adsehgal/STM_Dev_Boards/RedPill2/RedPill BOM.xlsx

LCSC Part Number | Manufacture Part Number | Manufacturer | Package | Customer # | Description | RoHS | Order Qty. | Min\Mult Order Qty. | Unit Price | Order Price | Product Link
C340475 | RMC1/10-104JTP | KAMAYA | 0805 |  | 100K ±5% 1/8W ±200ppm/℃ 0805 Chip Resistor - Surface Mount RoHS | yes | 50 | 50 | 0.003652 | 0.18 | lcsc.com/product-detail/Chip-Resistor-Surface-Mount_KAMAYA-RMC1-10-104JTP_C340475.html
C389817 | 7325-0800A2010-00 | XTY | SMD-3225-4P |  | 8MHz ±10ppm 20pF 400Ω SMD-3225-4P SMD Crystal Resonators RoHS | yes | 1 | 1 | 0.180555 | 0.18 | lcsc.com/product-detail/SMD-Crystal-Resonators_XTY-7325-0800A2010-00_C389817.html
C116501 | PTS810SJM250SMTRLFS | C&K | SMD |  | SPST-NO 50mA @ 16VDC Top Actuated Standard SMD Tactile Switches RoHS | yes | 1 | 1 | 0.178788 | 0.18 | lcsc.com/product-detail/Tactile-Switches_C-K-PTS810SJM250SMTRLFS_C116501.html
C48615 | Q13FC1350000200 | Seiko Epson | SMD-3215_2P |  | 32.768KHz ±20ppm 7pF 70kΩ SMD-3215_2P SMD Crystal Resonators RoHS | yes | 1 | 1 | 0.15303 | 0.15 | lcsc.com/product-detail/SMD-Crystal-Resonators_Seiko-Epson-Q13FC1350000200_C48615.html
C8734 | STM32F103C8T6 | STMicroelectronics | LQFP-48_7x7x05P |  | 32-Bit FLASH ARM® Cortex®-M3 72MHz 2V ~ 3.6V LQFP-48_7x7x05P ST Microelectronics RoHS | yes | 1 | 1 | 1.936364 | 1.94 | lcsc.com/product-detail/ST-Microelectronics_STMicroelectronics-STM32F103C8T6_C8734.html
C205449 | ORH-YG35A | Orient | 0805 |  | Green-yellow 566nm 0805 Light Emitting Diodes (LED) RoHS | yes | 50 | 50 | 0.008272 | 0.41 | lcsc.com/product-detail/Light-Emitting-Diodes-LED_Orient-ORH-YG35A_C205449.html
C163968 | WR08X1004FTL | Walsin Tech Corp | 0805 |  | 1M ±1% 1/8W ±100ppm/℃ 0805 Chip Resistor - Surface Mount RoHS | yes | 100 | 100 | 0.002043 | 0.2 | lcsc.com/product-detail/Chip-Resistor-Surface-Mount_Walsin-Tech-Corp-WR08X1004FTL_C163968.html
C408926 | CR-05JA7---20R | Viking Tech | 0805 |  | 20 ±5% 1/8W ±100ppm/℃ 0805 Chip Resistor - Surface Mount RoHS | yes | 100 | 100 | 0.001855 | 0.19 | lcsc.com/product-detail/Chip-Resistor-Surface-Mount_Viking-Tech-CR-05JA7-20R_C408926.html
C115337 | RS-05K512JT | FH(Guangdong Fenghua Advanced Tech) | 0805 |  | 5.1K ±5% 1/8W ±100ppm/℃ 0805 Chip Resistor - Surface Mount RoHS | yes | 100 | 100 | 0.002257 | 0.23 | lcsc.com/product-detail/Chip-Resistor-Surface-Mount_FH-Guangdong-Fenghua-Advanced-Tech-RS-05K512JT_C115337.html
C119075 | RS-05K331JT | FH(Guangdong Fenghua Advanced Tech) | 0805 |  | 330 ±5% 1/8W ±100ppm/℃ 0805 Chip Resistor - Surface Mount RoHS | yes | 100 | 100 | 0.002133 | 0.21 | lcsc.com/product-detail/Chip-Resistor-Surface-Mount_FH-Guangdong-Fenghua-Advanced-Tech-RS-05K331JT_C119075.html
C103904 | RTT051002FTP | RALEC | 0805 |  | 10K ±1% 1/8W ±100ppm/℃ 0805 Chip Resistor - Surface Mount RoHS | yes | 100 | 100 | 0.002046 | 0.2 | lcsc.com/product-detail/Chip-Resistor-Surface-Mount_RALEC-RTT051002FTP_C103904.html
C465168 | HGC0805G0220J500NTGJ | Chinocera | 0805 |  | 22pF ±5% 50V C0G 0805 Multilayer Ceramic Capacitors MLCC - SMD/SMT RoHS | yes | 50 | 50 | 0.010723 | 0.54 | lcsc.com/product-detail/Multilayer-Ceramic-Capacitors-MLCC-SMD-SMT_Chinocera-HGC0805G0220J500NTGJ_C465168.html
C116352 | CL21B105KAFNNNE | Samsung Electro-Mechanics | 0805 |  | 1uF ±10% 25V X7R 0805 Multilayer Ceramic Capacitors MLCC - SMD/SMT RoHS | yes | 50 | 50 | 0.012231 | 0.61 | lcsc.com/product-detail/Multilayer-Ceramic-Capacitors-MLCC-SMD-SMT_Samsung-Electro-Mechanics-CL21B105KAFNNNE_C116352.html
C282732 | TCC0805X7R104K500DT | CCTC | 0805 |  | 100nF ±10% 50V X7R 100nF ±10% 50V X7R 0805 Multilayer Ceramic Capacitors MLCC - SMD/SMT RoHS | yes | 50 | 50 | 0.01487 | 0.74 | lcsc.com/product-detail/Multilayer-Ceramic-Capacitors-MLCC-SMD-SMT_CCTC-TCC0805X7R104K500DT_C282732.html
C39051 | MCP1700T-3302E/TT | Microchip Tech | SOT-23(SOT-23-3) |  | Fixed 6V 3.3V 250mA SOT-23(SOT-23-3) Low Dropout Regulators(LDO) RoHS | yes | 1 | 1 | 0.280303 | 0.28 | lcsc.com/product-detail/Low-Dropout-Regulators-LDO_Microchip-Tech-MCP1700T-3302E-TT_C39051.html
