adsehgal/STM_Dev_Boards/RedPill2/Schematic.pdf

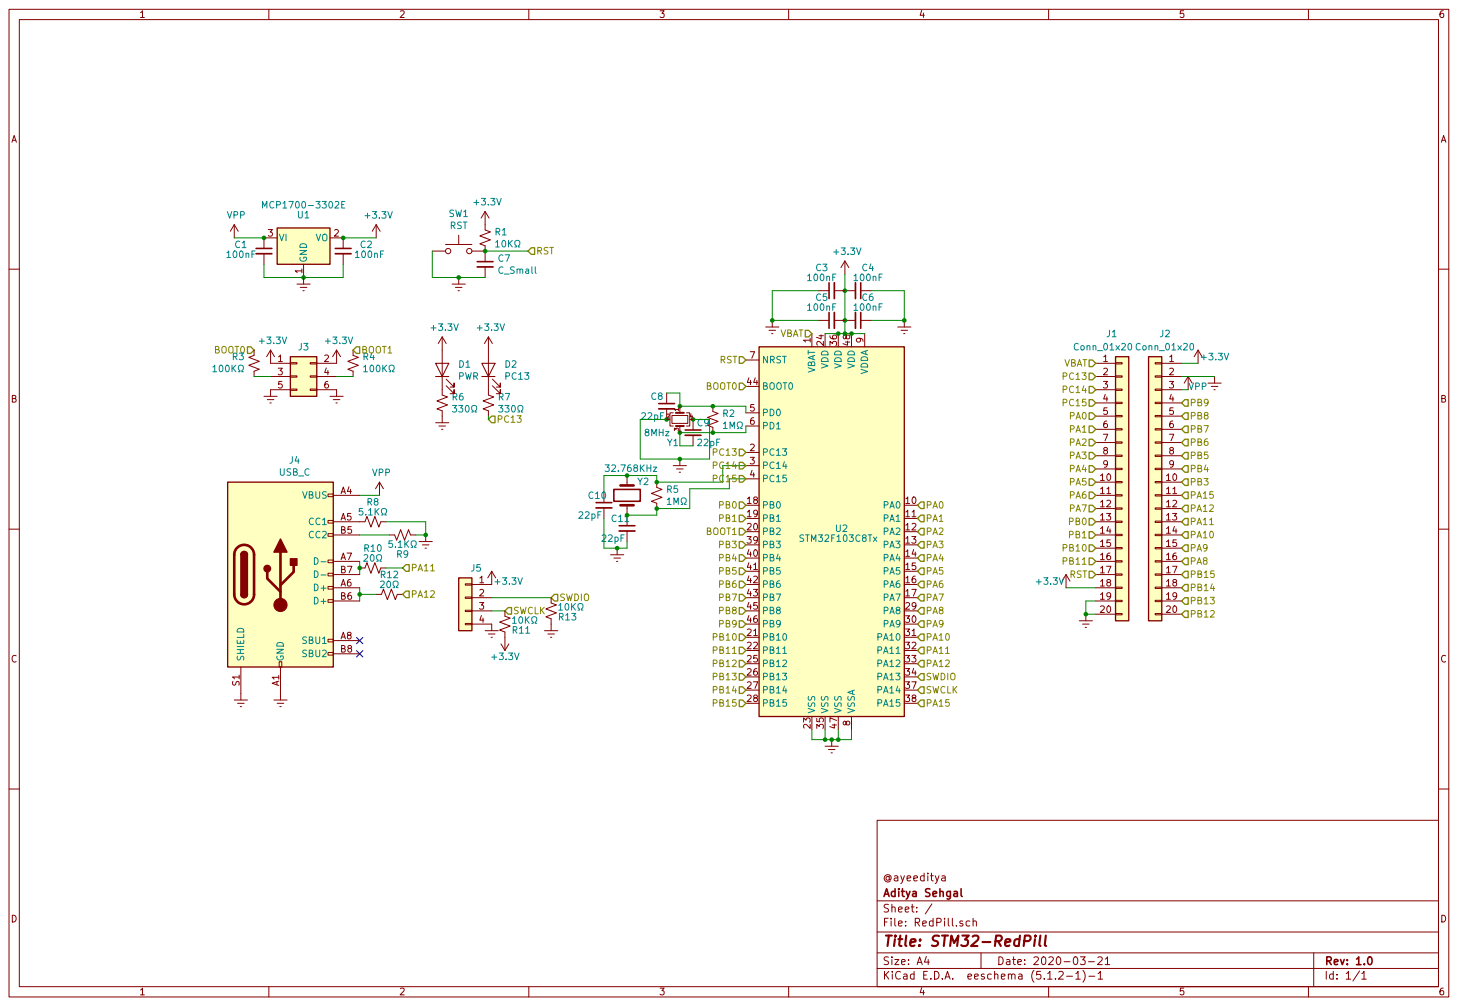
[picture p1: page 1]

1 VDD 24 VDD 36 VDD 48 VDDA

9 VSS 23 VSS 35 VSS 47 VSSA

@ayeeditya
Id: 1/1 Title: STM32-RedPill File: RedPill.sch Sheet: / Aditya Sehgal
