adsehgal/STM_Dev_Boards/STM32F103Cxxx/STM32F103Cxxx.kicad_sch

## KiCad design STM32F103Cxxx/STM32F103Cxxx.kicad_sch (2020-09-07)

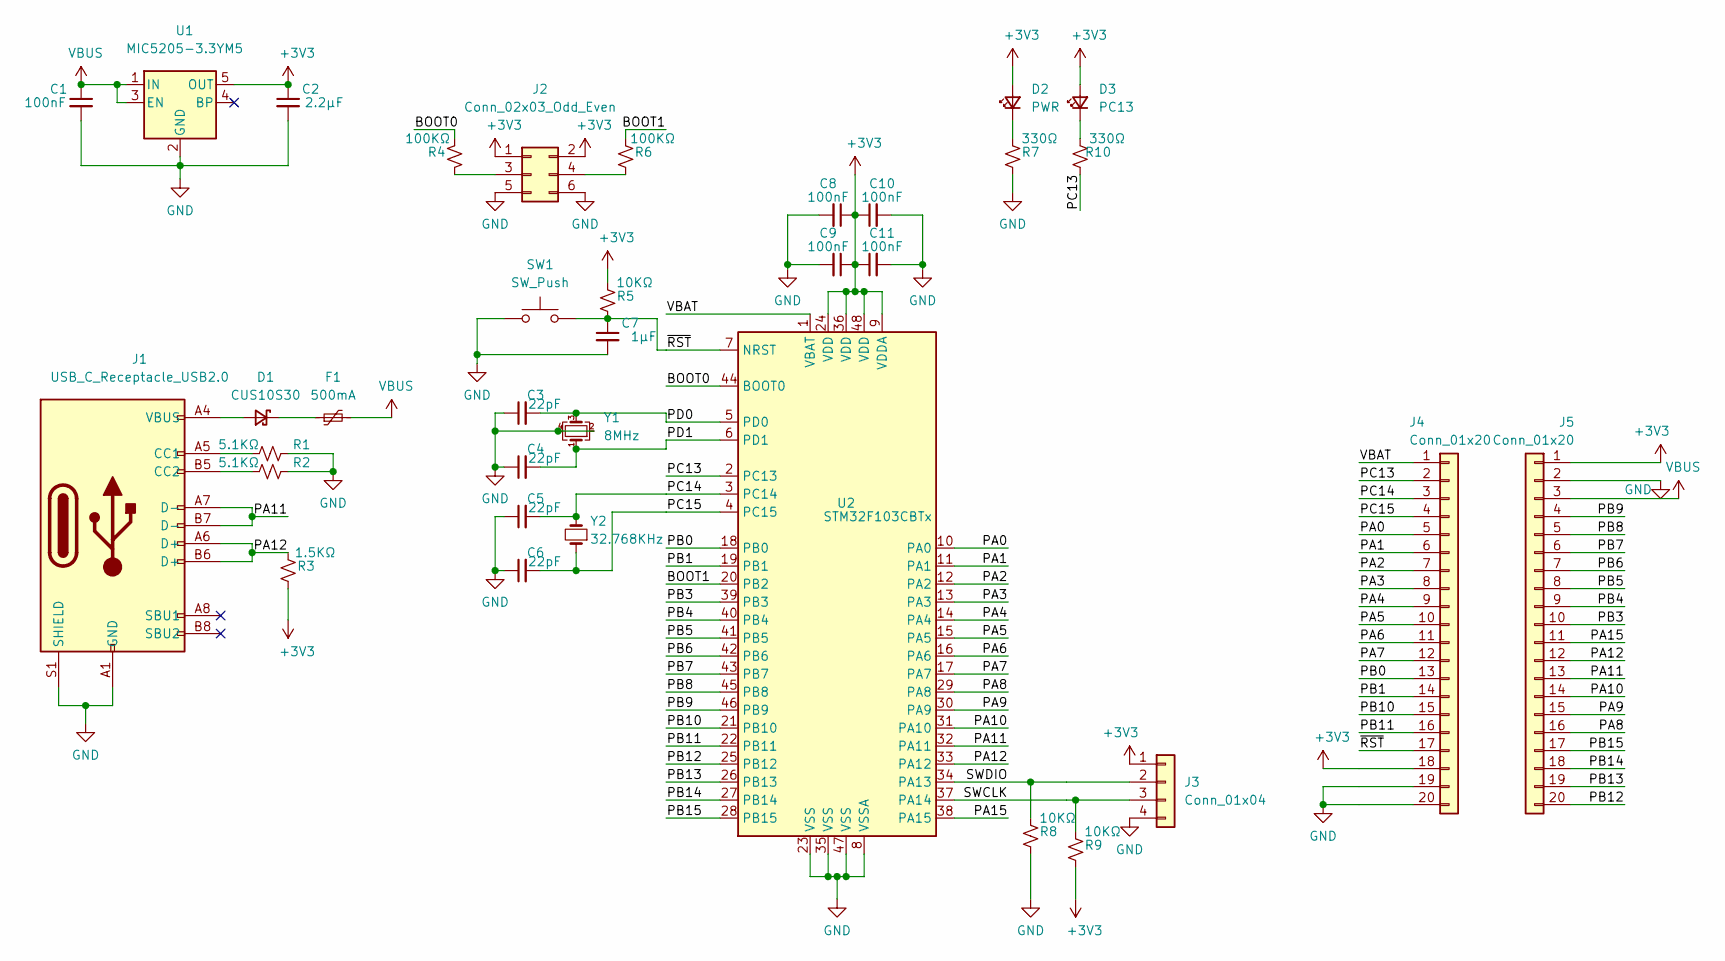
[picture p2: schematic STM32F103Cxxx.kicad_sch]

Parts:
C1, C8, C9, C10, C11: 100nF; C_0603_1608Metric
C2: 2.2µF; C_0603_1608Metric
C3, C4, C5, C6: 22pF; C_0603_1608Metric
C7: 1µF; C_0603_1608Metric
D1: CUS10S30; D_SOD-323
D2: PWR; LED_0603_1608Metric_Castellated
D3: PC13; LED_0603_1608Metric_Castellated
F1: 500mA; Fuse_0603_1608Metric_Castellated
J1: USB_C_Receptacle_USB2.0; USB_C_Receptacle_Palconn_UTC16-G
J2: Conn_02x03_Odd_Even; PinHeader_2x03_P1.27mm_Vertical
J3: Conn_01x04; PinHeader_1x04_P1.27mm_Vertical
J4, J5: Conn_01x20; PinHeader_1x20_P2.54mm_Vertical
R1, R2: 5.1KΩ; R_0603_1608Metric
R3: 1.5KΩ; R_0603_1608Metric
R4, R6: 100KΩ; R_0603_1608Metric
R5, R8, R9: 10KΩ; R_0603_1608Metric
R7, R10: 330Ω; R_0603_1608Metric
SW1: SW_Push; SW_SPST_TL3342
U1: MIC5205-3.3YM5; SOT-23-5
U2: STM32F103CBTx; LQFP-48_7x7mm_P0.5mm
Y1: 8MHz; Crystal_SMD_3225-4Pin_3.2x2.5mm
Y2: 32.768KHz; Crystal_SMD_MicroCrystal_CC7V-T1A-2Pin_3.2x1.5mm

Connections:
+3V3: C2.1, C8.1, C9.1, C10.1, C11.1, D2.2 (A), D3.2 (A), J2.1, J2.2, J3.1, J4.18, J5.1, R3.1, R5.2, R9.1, U1.5 (OUT), U2.9 (VDDA), U2.24 (VDD), U2.36 (VDD), U2.48 (VDD)
BOOT0: R4.2, U2.44 (BOOT0)
BOOT1: R6.2, U2.20 (PB2)
GND: C1.2, C2.2, C3.1, C4.1, C5.1, C6.1, C7.2, C8.2, C9.2, C10.2, C11.2, J1.A1 (GND), J1.A12 (GND), J1.B1 (GND), J1.B12 (GND), J1.S1 (SHIELD), J2.5, J2.6, J3.4, J4.19, J4.20, J5.2, R1.2, R2.2, R7.1, R8.1, SW1.1, U1.2 (GND), U2.8 (VSSA), U2.23 (VSS), U2.35 (VSS), U2.47 (VSS), Y1.2, Y1.4
unnamed: D1.1 (K), F1.1
unnamed: D1.2 (A), J1.A4 (VBUS), J1.A9 (VBUS), J1.B4 (VBUS), J1.B9 (VBUS)
unnamed: D2.1 (K), R7.2
unnamed: D3.1 (K), R10.2
unnamed: J1.A5 (CC1), R1.1
unnamed: J1.B5 (CC2), R2.1
unnamed: J2.3, R4.1
unnamed: J2.4, R6.1
PA0: J4.5, U2.10 (PA0)
PA1: J4.6, U2.11 (PA1)
PA2: J4.7, U2.12 (PA2)
PA3: J4.8, U2.13 (PA3)
PA4: J4.9, U2.14 (PA4)
PA5: J4.10, U2.15 (PA5)
PA6: J4.11, U2.16 (PA6)
PA7: J4.12, U2.17 (PA7)
PA8: J5.16, U2.29 (PA8)
PA9: J5.15, U2.30 (PA9)
PA10: J5.14, U2.31 (PA10)
PA11: J1.A7 (D-), J1.B7 (D-), J5.13, U2.32 (PA11)
PA12: J1.A6 (D+), J1.B6 (D+), J5.12, R3.2, U2.33 (PA12)
PA15: J5.11, U2.38 (PA15)
PB0: J4.13, U2.18 (PB0)
PB1: J4.14, U2.19 (PB1)
PB3: J5.10, U2.39 (PB3)
PB4: J5.9, U2.40 (PB4)
PB5: J5.8, U2.41 (PB5)
PB6: J5.7, U2.42 (PB6)
PB7: J5.6, U2.43 (PB7)
PB8: J5.5, U2.45 (PB8)
PB9: J5.4, U2.46 (PB9)
PB10: J4.15, U2.21 (PB10)
PB11: J4.16, U2.22 (PB11)
PB12: J5.20, U2.25 (PB12)
PB13: J5.19, U2.26 (PB13)
PB14: J5.18, U2.27 (PB14)
PB15: J5.17, U2.28 (PB15)
PC13: J4.2, R10.1, U2.2 (PC13)
PC14: C5.2, J4.3, U2.3 (PC14), Y2.2
PC15: C6.2, J4.4, U2.4 (PC15), Y2.1
PD0: C3.2, U2.5 (PD0), Y1.3
PD1: C4.2, U2.6 (PD1), Y1.1
SWCLK: J3.3, R9.2, U2.37 (PA14)
SWDIO: J3.2, R8.2, U2.34 (PA13)
VBAT: J4.1, U2.1 (VBAT)
VBUS: C1.1, F1.2, J5.3, U1.1 (IN), U1.3 (EN)
~RST: C7.1, J4.17, R5.1, SW1.2, U2.7 (NRST)
