adsehgal/STM_Dev_Boards/(commit log)

2020-03-20 Blue pill schematic started
    [BluePill.kicad_pcb]
2020-03-21 schematic-ldo added
2020-03-21 Gerber push
    [BluePill.kicad_pcb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]
2020-03-21 BOM Push
    [RedPill BOM.xlsx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]
2020-09-07 completed layout for stm32f103 breakout board
    [RedPill BOM.xlsx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]
